MehmetBurakYilmaz55/Basys3-FPGA-4x4-Keypad-Verilog/docs/Schematic_Diagram.pdf

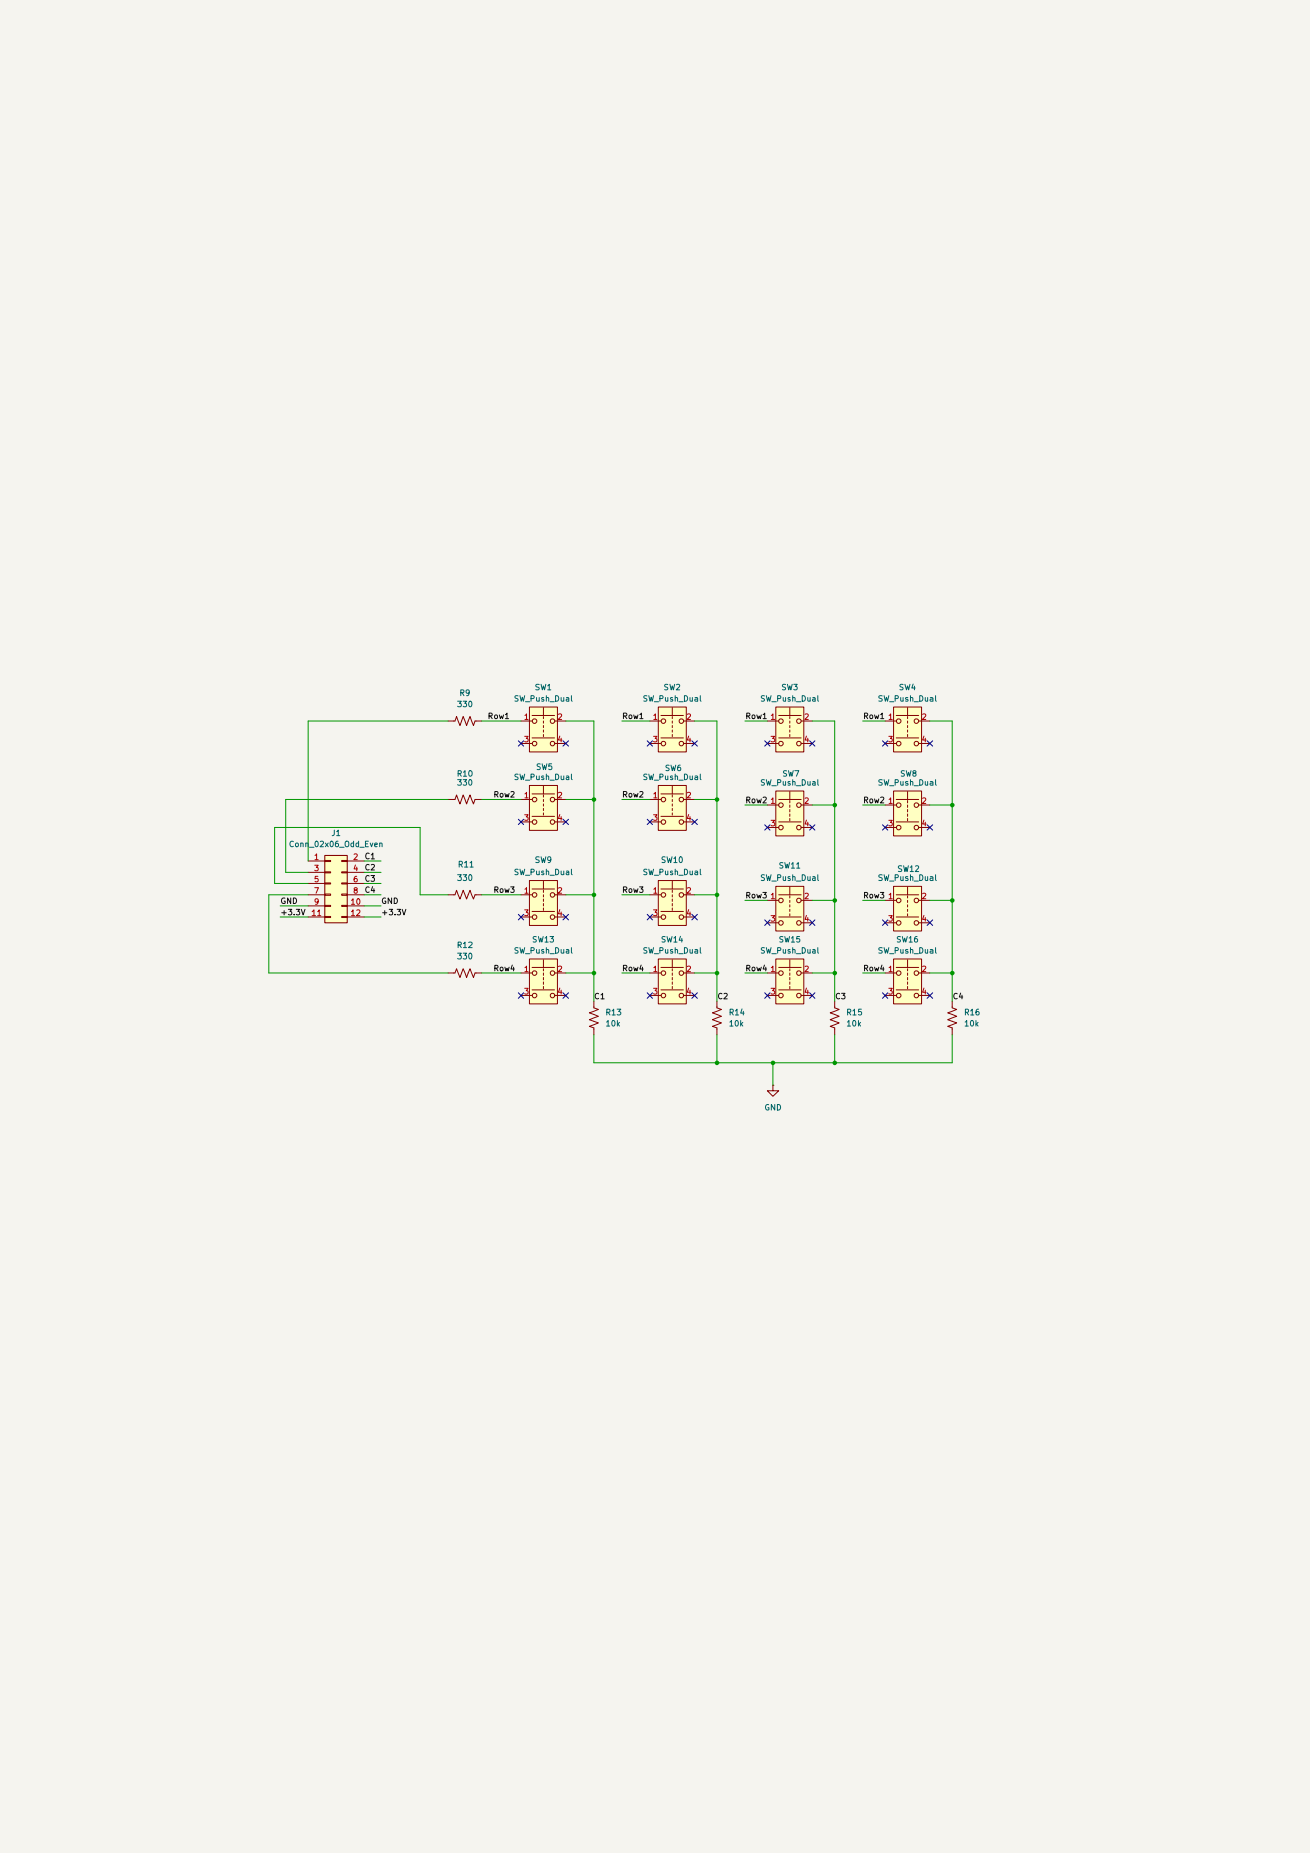
[picture p8: page 1]
