MehmetBurakYilmaz55/Basys3-FPGA-4x4-Keypad-Verilog/pcb_design/SayTasProje.kicad_pcb

## KiCad design pcb_design/SayTasProje.kicad_pcb (2026-01-09)

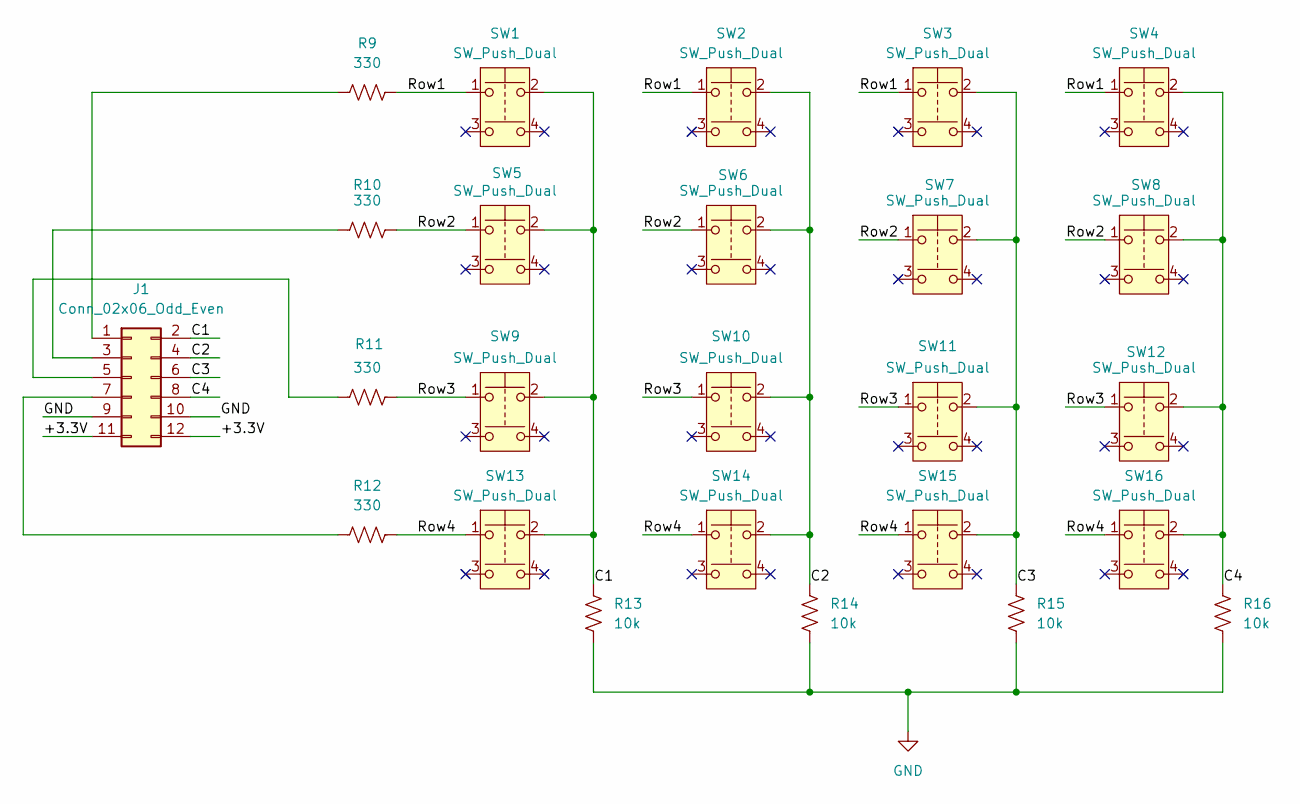
[picture p9: schematic SayTasProje.kicad_sch]

Parts:
J1: Conn_02x06_Odd_Even; PinHeader_2x06_P2.54mm_Horizontal
R9, R10, R11, R12: 330; SMD_Res_Big_Pad
R13, R14, R15, R16: 10k; SMD_Res_Big_Pad
SW1, SW2, SW3, SW4, SW5, SW6, SW7, SW8, SW9, SW10, SW11, SW12, SW13, SW14, SW15, SW16: SW_Push_Dual; SW_SPST_PTS645Sx43SMTR92

Connections:
+3.3V: J1.11, J1.12
/C1: J1.2, R13.2, SW1.2, SW5.2, SW9.2, SW13.2
/C2: J1.4, R14.2, SW2.2, SW6.2, SW10.2, SW14.2
/C3: J1.6, R15.2, SW3.2, SW7.2, SW11.2, SW15.2
/C4: J1.8, R16.2, SW4.2, SW8.2, SW12.2, SW16.2
/Row1: R9.2, SW1.1, SW2.1, SW3.1, SW4.1
/Row2: R10.2, SW5.1, SW6.1, SW7.1, SW8.1
/Row3: R11.2, SW9.1, SW10.1, SW11.1, SW12.1
/Row4: R12.2, SW13.1, SW14.1, SW15.1, SW16.1
GND: J1.9, J1.10, R13.1, R14.1, R15.1, R16.1
unnamed: J1.1, R9.1
unnamed: J1.3, R10.1
unnamed: J1.5, R11.1
unnamed: J1.7, R12.1

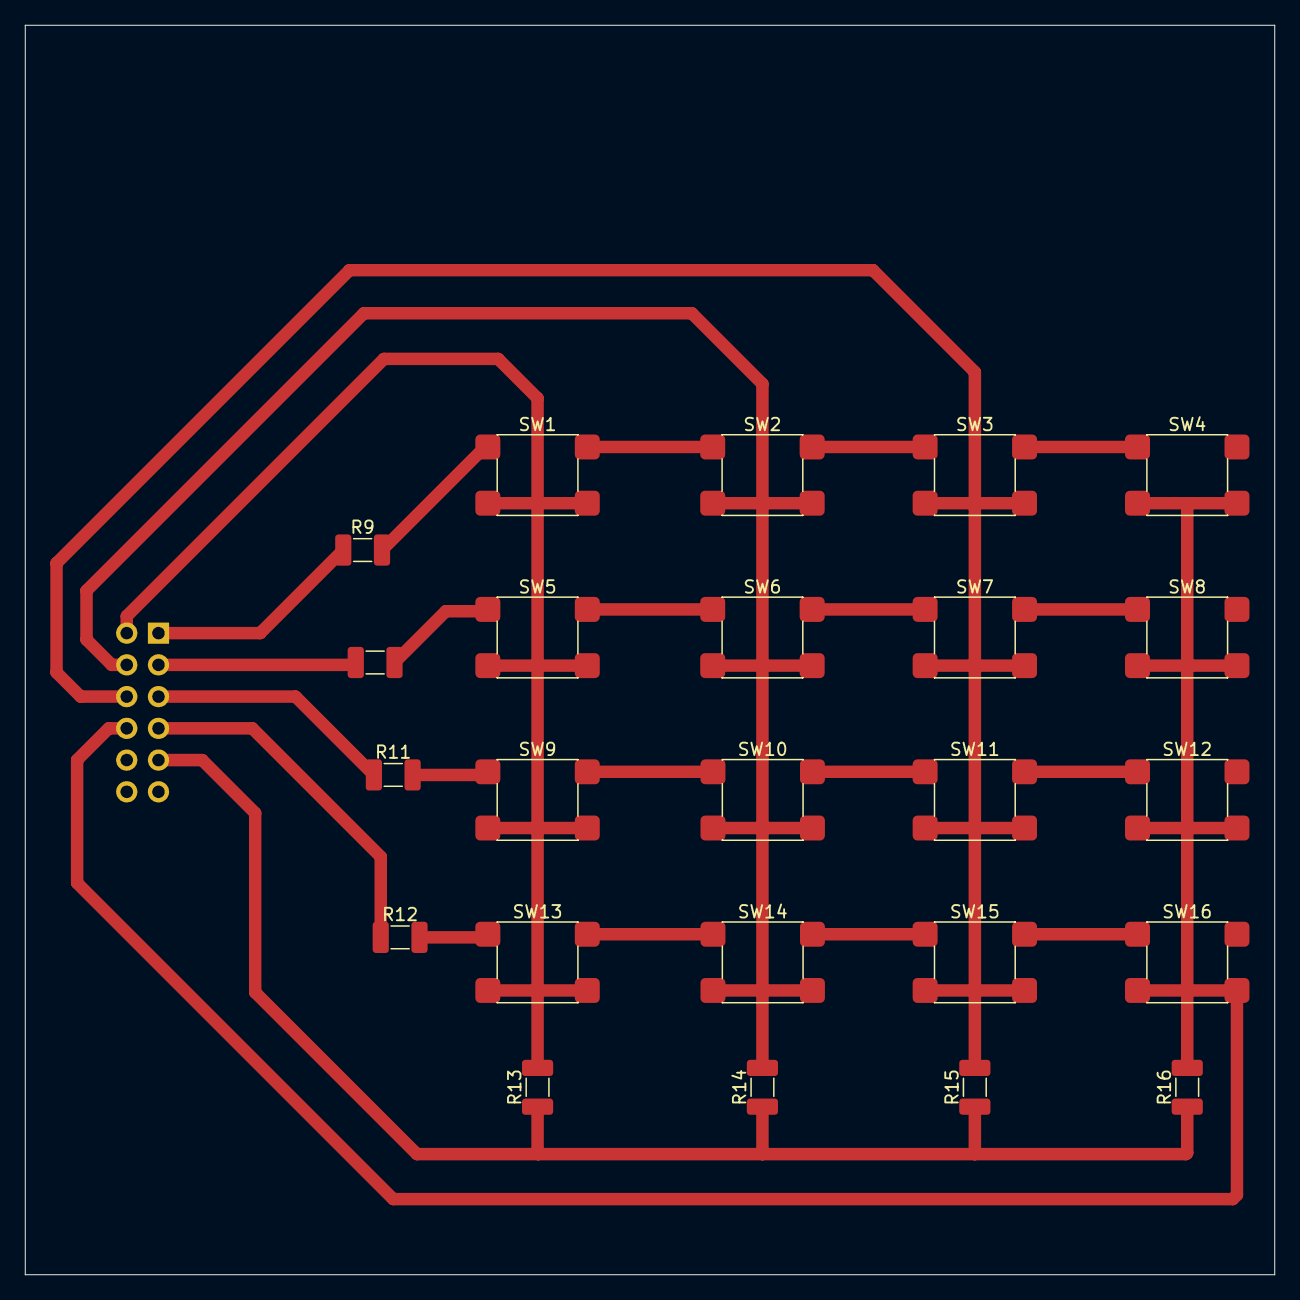
[picture p10: board SayTasProje.kicad_pcb from above]

Board: 2 copper layers, 100.0 x 100.0 mm, 25 parts (1 on the bottom side), 14 nets.
